dadamkovic/battery_charger_dev/hardware/production_data/v1.0/battery_charging_devboard_BOM.ods

Reference | Value | Footprint | Cost | Price | Vendor | Qty | Cost
BT1-BT3 | 18650 | User_Battery:Battery_18650 |  |  |  | 3 | 0
C1, C6, C8, C10-C15, C27-C30 | 0.1u | Capacitor_SMD:C_0805_2012Metric_Pad1.18x1.45mm_HandSolder |  |  |  | 13 | 0
C2, C3, C5, C23 | 1u | Capacitor_SMD:C_0805_2012Metric_Pad1.18x1.45mm_HandSolder |  |  |  | 4 | 0
C4 | 3.3u | Capacitor_SMD:C_0805_2012Metric_Pad1.18x1.45mm_HandSolder |  |  |  | 1 | 0
C7 | 2200p | Capacitor_SMD:C_0805_2012Metric_Pad1.18x1.45mm_HandSolder |  |  |  | 1 | 0
C9 | 2.2u | Capacitor_SMD:C_0805_2012Metric_Pad1.18x1.45mm_HandSolder |  |  |  | 1 | 0
C16 | 0.047u | Capacitor_SMD:C_0805_2012Metric_Pad1.18x1.45mm_HandSolder |  |  |  | 1 | 0
C17-C22 | 10u | Capacitor_SMD:C_1206_3216Metric_Pad1.33x1.80mm_HandSolder |  | 0.09 | https://www.mouser.com/ProductDetail/Samsung-Electro-Mechanics/CL31B106KAHNFNE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 | 6 | 0.54
C24 | 0.33u | Capacitor_SMD:C_0805_2012Metric_Pad1.18x1.45mm_HandSolder |  | 0.065 | https://www.mouser.com/ProductDetail/Samsung-Electro-Mechanics/CL21B105KOFNFNE | 1 | 0.065
C25 | 100p | Capacitor_SMD:C_0805_2012Metric_Pad1.18x1.45mm_HandSolder |  |  |  | 1 | 0
C26 | 0.01u | Capacitor_SMD:C_0805_2012Metric_Pad1.18x1.45mm_HandSolder |  |  |  | 1 | 0
C31 | 220u | Capacitor_SMD:CP_Elec_8x10 |  | 0.286 | https://www.mouser.com/ProductDetail/Nichicon/UWT1V221MNL1GS | 0 | 0
D1, D4, D12 | BAT54WS | Diode_SMD:D_SOD-323_HandSoldering |  | 0.08 | https://www.mouser.com/ProductDetail/Diodes-Incorporated/BAT54WS-7-F?qs=BJo294706GxanB6a%2FKrrdw%3D%3D | 3 | 0.24
D2 | SBR8M | Diode_SMD:D_PowerDI-5 |  | 0.48 | https://www.mouser.com/ProductDetail/Diodes-Incorporated/SBR8M100P5-13?qs=nJRy1mI8RR96yMJWqGg%252BEg%3D%3D | 1 | 0.48
D3 | BAT54C | Package_TO_SOT_SMD:SOT-23 |  | 0.113 | https://www.mouser.com/ProductDetail/onsemi/BAT54CLT3G?qs=CBDP9nzV7kkNgCKU97dzRw%3D%3D | 1 | 0.113
D5-D10 | LED | LED_SMD:LED_0805_2012Metric_Pad1.15x1.40mm_HandSolder |  |  |  | 6 | 0
D11 | MMSZ4684-TP | Diode_SMD:D_SOD-123 |  | 0.9 | https://www.mouser.com/ProductDetail/Micro-Commercial-Components-MCC/MMSZ4684-TP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 | 1 | 0.9
J1 | Conn_01x02_Male | Connector_PinHeader_2.54mm:PinHeader_1x02_P2.54mm_Vertical |  |  |  | 1 | 0
J2 | USB_C_Receptacle_USB2.0 | Connector_USB:USB_C_Receptacle_Amphenol_12401610E4-2A |  | 1.33 | https://www.mouser.com/ProductDetail/Amphenol-Commercial-Products/12401610E42A?qs=EgDjlb95zqAWvChv41w5lg%3D%3D | 1 | 1.33
J3 | DEBUG_CONN | Connector_PinHeader_2.54mm:PinHeader_1x04_P2.54mm_Horizontal |  |  | https://www.mouser.com/ProductDetail/Amphenol-FCI/78938-404HLF?qs=Owp1TJ%252B9apjkzJNnr0tajw%3D%3D | 1 | 0
J4 | UART_CONN | Connector_PinHeader_2.54mm:PinHeader_1x04_P2.54mm_Horizontal |  |  |  | 1 | 0
J5 | COMM_SELECT | Connector_PinHeader_2.54mm:PinHeader_2x06_P2.54mm_Vertical_SMD |  |  |  | 1 | 0
J6 | UART_SUPP | Connector_PinHeader_2.54mm:PinHeader_1x02_P2.54mm_Vertical_SMD_Pin1Left |  |  |  | 1 | 0
J7 | OUT_SUP | Connector_PinHeader_2.54mm:PinHeader_1x02_P2.54mm_Vertical |  |  |  | 1 | 0
L1 | 4.7u | Inductor_SMD:L_Bourns_SRN8040TA |  | 0.38 | https://www.mouser.com/ProductDetail/Bourns/SRN8040TA-4R7M?qs=Vt59ZOdFuWY5hsZr6KKjGg%3D%3D | 1 | 0.38
Q1, Q2 | DMP3036SSD | Package_SO:SO-8_3.9x4.9mm_P1.27mm |  | 0.8 | https://www.mouser.com/ProductDetail/Diodes-Incorporated/DMP3036SSD-13?qs=OVC8WVYZliQQ%252Bz8nd4Q8aA%3D%3D | 2 | 1.6
Q3 | MUN5335DW1T2G | Package_TO_SOT_SMD:SOT-363_SC-70-6_Handsoldering |  | 0.25 | https://www.mouser.com/ProductDetail/onsemi/MUN5335DW1T2G?qs=Gev%252BmEvV0ibQS1roQsXG0Q%3D%3D | 1 | 0.25
R1, R2 | 1k | Resistor_SMD:R_0805_2012Metric_Pad1.20x1.40mm_HandSolder |  |  |  | 2 | 0
R3, R4 | 49.9k | Resistor_SMD:R_0805_2012Metric_Pad1.20x1.40mm_HandSolder |  |  |  | 2 | 0
R5, R25, R35, R37, R43 | 10k | Resistor_SMD:R_0805_2012Metric_Pad1.20x1.40mm_HandSolder |  |  |  | 5 | 0
R6 | 2 | Resistor_SMD:R_0805_2012Metric_Pad1.20x1.40mm_HandSolder |  |  |  | 1 | 0
R7, R8, R33 | 4k | Resistor_SMD:R_0805_2012Metric_Pad1.20x1.40mm_HandSolder |  |  |  | 3 | 0
R9, R11, R29 | 10 | Resistor_SMD:R_0805_2012Metric_Pad1.20x1.40mm_HandSolder |  |  |  | 3 | 0
R10, R12 | 10m | Resistor_SMD:R_1206_3216Metric_Pad1.30x1.75mm_HandSolder |  | 0.15 | https://www.mouser.com/ProductDetail/Bussmann-Eaton/MFL1206R0100FS | 2 | 0.3
R13, R16, R19-R22, R27 | 5.1k | Resistor_SMD:R_0805_2012Metric_Pad1.20x1.40mm_HandSolder |  |  |  | 7 | 0
R14, R17, R42, R45, R46 | 2k | Resistor_SMD:R_0805_2012Metric_Pad1.20x1.40mm_HandSolder |  |  |  | 5 | 0
R15 | N/A | Resistor_SMD:R_0805_2012Metric_Pad1.20x1.40mm_HandSolder |  |  |  | 1 | 0
R18 | 0k | Resistor_SMD:R_0805_2012Metric_Pad1.20x1.40mm_HandSolder |  |  |  | 1 | 0
R23 | 4.7K | Resistor_SMD:R_0805_2012Metric_Pad1.20x1.40mm_HandSolder |  |  |  | 1 | 0
R24, R28 | 2.2k | Resistor_SMD:R_0805_2012Metric_Pad1.20x1.40mm_HandSolder |  |  |  | 2 | 0
R26, R34, R36 | 50k | Resistor_SMD:R_0805_2012Metric_Pad1.20x1.40mm_HandSolder |  |  |  | 3 | 0
R30 | 316k | Resistor_SMD:R_0805_2012Metric_Pad1.20x1.40mm_HandSolder |  |  |  | 1 | 0
R31 | 430k | Resistor_SMD:R_0805_2012Metric_Pad1.20x1.40mm_HandSolder |  |  |  | 1 | 0
R32 | 66.5k | Resistor_SMD:R_0805_2012Metric_Pad1.20x1.40mm_HandSolder |  |  |  | 1 | 0
R38-R41 | 660 | Resistor_SMD:R_0805_2012Metric_Pad1.20x1.40mm_HandSolder |  |  |  | 4 | 0
R44 | 58k | Resistor_SMD:R_0805_2012Metric_Pad1.20x1.40mm_HandSolder |  |  |  | 1 | 0
SW1 | BAT_IND | Button_Switch_SMD:SW_SPST_PTS810 |  | 0.3 | https://www.mouser.com/ProductDetail/CK/PTS810SJK250SMTRLFS?qs=UxeAxwACbqlfHzoZSrW3%2Fw%3D%3D | 1 | 0.3
TP1, TP3 | HPI_INT | TestPoint:TestPoint_Pad_2.5x2.5mm |  |  |  | 2 | 0
TP2 | ACOK_TP | TestPoint:TestPoint_Pad_2.5x2.5mm |  |  |  | 1 | 0
TP4 | debug_gnd | TestPoint:TestPoint_Pad_D1.0mm |  |  |  | 1 | 0
TP5 | debug_swdio | TestPoint:TestPoint_Pad_D1.0mm |  |  |  | 1 | 0
TP6 | debug_3V3 | TestPoint:TestPoint_Pad_D1.0mm |  |  |  | 1 | 0
TP7 | debug_swclk | TestPoint:TestPoint_Pad_D1.0mm |  |  |  | 1 | 0
U1, U2, U4-U6 | RQ3E100BN | User_Mosfet:HSMT8 |  | 0.3 | https://www.mouser.com/ProductDetail/ROHM-Semiconductor/RQ3E100BNTB?qs=npTsUczJOtO8HxsK5LUjOw%3D%3D | 5 | 1.5
U3 | BQ24725A | Package_DFN_QFN:Texas_S-PVQFN-N20_EP2.4x2.4mm |  | 2.9 | https://www.mouser.com/ProductDetail/Texas-Instruments/BQ24725ARGRR?qs=wqKrPCMdR%252BaY3f%2FZIDhYvQ%3D%3D | 1 | 2.9
U7 | CYPD3177 | Package_DFN_QFN:QFN-24-1EP_4x4mm_P0.5mm_EP2.65x2.65mm |  | 2.2 | https://www.mouser.com/ProductDetail/Infineon-Technologies/CYPD3177-24LQXQ?qs=PzGy0jfpSMvR3aDH5AdWfA%3D%3D | 1 | 2.2
U8 | T2N7002AK | Package_TO_SOT_SMD:SOT-23 |  | 0.14 | https://www.mouser.com/ProductDetail/Toshiba/T2N7002AKLM?qs=pzVvXTvk9PzfX4hYglwZ9Q%3D%3D | 1 | 0.14
U9 | STM32F042F6Px | Package_SO:TSSOP-20_4.4x6.5mm_P0.65mm |  | 3 |  | 1 | 3
U10 | L78L33_SO8 | Package_SO:SOIC-8_3.9x4.9mm_P1.27mm |  | 0.1 |  | 1 | 0.1
Total |  |  |  |  |  | #NAME? | 16.338
