dadamkovic/battery_charger_dev/hardware/battery_charging_devboard.kicad_pcb

## KiCad design hardware/battery_charging_devboard.kicad_pcb (2024-06-29)

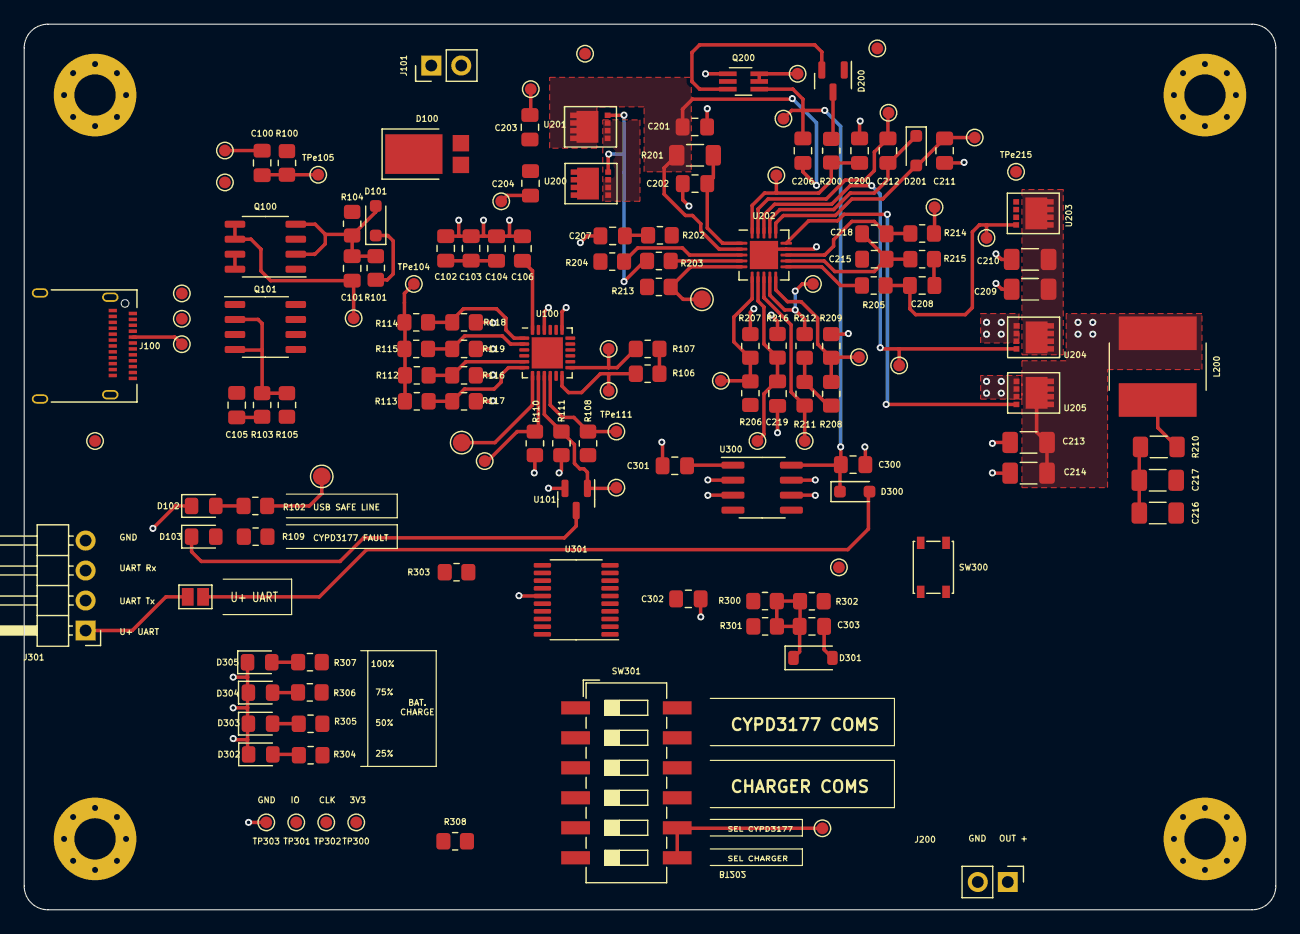
[picture p1: board battery_charging_devboard.kicad_pcb from above]

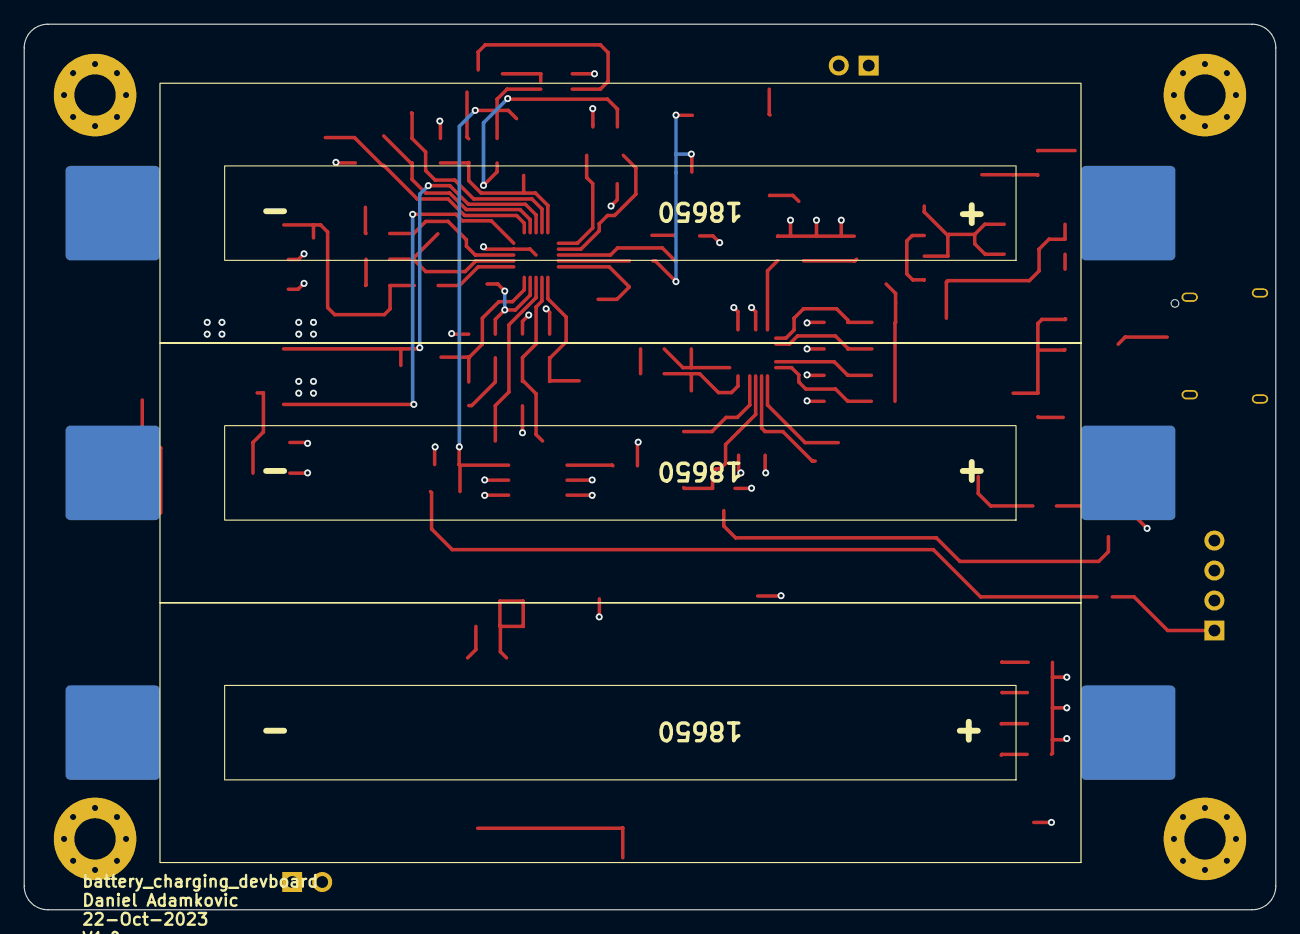
[picture p2: board battery_charging_devboard.kicad_pcb from below]

Board: 4 copper layers, 106.0 x 75.0 mm, 157 parts (3 on the bottom side), 84 nets.

Parts:
B501, B502, B503, B504: MountingHole_Pad; MountingHole_3.5mm_Pad_Via
BT200, BT201, BT202: 18650; Battery_18650
C100, C101, C102, C106: 1u; C_0805_2012Metric_Pad1.18x1.45mm_HandSolder
C103, C104, C200, C201, C202, C204, C206, C211, C215, C218, C301, C302, C303: 0.1u; C_0805_2012Metric_Pad1.18x1.45mm_HandSolder
C105: 3.3u; C_0805_2012Metric_Pad1.18x1.45mm_HandSolder
C203: 2200p; C_0805_2012Metric_Pad1.18x1.45mm_HandSolder
C207: 2.2u; C_0805_2012Metric_Pad1.18x1.45mm_HandSolder
C208: 0.01u; C_0805_2012Metric_Pad1.18x1.45mm_HandSolder
C209, C210, C213, C214, C216, C217: 10u; C_1206_3216Metric_Pad1.33x1.80mm_HandSolder
C212: 0.047u; C_0805_2012Metric_Pad1.18x1.45mm_HandSolder
C219: 100p; C_0805_2012Metric_Pad1.18x1.45mm_HandSolder
C300: 0.33u; C_0805_2012Metric_Pad1.18x1.45mm_HandSolder
D100: SBR8M; D_PowerDI-5
D101, D201, D300: BAT54WS; D_SOD-323_HandSoldering
D102, D103, D302, D303, D304, D305: LED; LED_0805_2012Metric_Pad1.15x1.40mm_HandSolder
D200: BAT54C; SOT-23
D301: MMSZ4684-TP; D_SOD-123
J100: USB_C_Receptacle_USB2.0; USB_C_Receptacle_Amphenol_12401610E4-2A
J101: Conn_01x02_Male; PinHeader_1x02_P2.54mm_Vertical
J200: OUT_SUP; PinHeader_1x02_P2.54mm_Vertical
J300: UART_SUPP; SolderJumper-2_P1.3mm_Open_Pad1.0x1.5mm
J301: UART_CONN; PinHeader_1x04_P2.54mm_Horizontal
L200: 4.7u; L_Bourns_SRN8040TA
Q100, Q101: DMP3036SSD; SO-8_3.9x4.9mm_P1.27mm
Q200: MUN5335DW1T2G; SOT-363_SC-70-6_Handsoldering
R100, R211, R212, R213, R302: 10k; R_0805_2012Metric_Pad1.20x1.40mm_HandSolder
R101, R103: 49.9k; R_0805_2012Metric_Pad1.20x1.40mm_HandSolder
R102, R109, R301, R303, R308: 2k; R_0805_2012Metric_Pad1.20x1.40mm_HandSolder
R104, R105: 1k; R_0805_2012Metric_Pad1.20x1.40mm_HandSolder
R106, R107: 2.2k; R_0805_2012Metric_Pad1.20x1.40mm_HandSolder
R108: 4.7K; R_0805_2012Metric_Pad1.20x1.40mm_HandSolder
R110, R112, R114, R116, R117, R118, R119: 5.1k; R_0805_2012Metric_Pad1.20x1.40mm_HandSolder
R111, R209, R216: 50k; R_0805_2012Metric_Pad1.20x1.40mm_HandSolder
R113: N/A; R_0805_2012Metric_Pad1.20x1.40mm_HandSolder
R115: 0k; R_0805_2012Metric_Pad1.20x1.40mm_HandSolder
R200, R214, R215: 10; R_0805_2012Metric_Pad1.20x1.40mm_HandSolder
R201, R210: 10m; R_1206_3216Metric_Pad1.30x1.75mm_HandSolder
R202: 2; R_0805_2012Metric_Pad1.20x1.40mm_HandSolder
R203, R204, R205: 4k; R_0805_2012Metric_Pad1.20x1.40mm_HandSolder
R206: 430k; R_0805_2012Metric_Pad1.20x1.40mm_HandSolder
R207: 66.5k; R_0805_2012Metric_Pad1.20x1.40mm_HandSolder
R208: 316k; R_0805_2012Metric_Pad1.20x1.40mm_HandSolder
R300: 58k; R_0805_2012Metric_Pad1.20x1.40mm_HandSolder
R304, R305, R306, R307: 660; R_0805_2012Metric_Pad1.20x1.40mm_HandSolder
SW300: BAT_IND; SW_SPST_PTS810
SW301: SW_DIP_x06; SW_DIP_SPSTx06_Slide_6.7x16.8mm_W8.61mm_P2.54mm_LowProfile
TP100, TP101: HPI_INT; TestPoint_Pad_D1.5mm
TP200: ACOK_TP; TestPoint_Pad_D1.5mm
TP300: debug_3V3; TestPoint_Pad_D1.0mm
TP301: debug_swdio; TestPoint_Pad_D1.0mm
TP302: debug_swclk; TestPoint_Pad_D1.0mm
TP303: debug_gnd; TestPoint_Pad_D1.0mm
TPe100, TPe101, TPe102, TPe103, TPe104, TPe105, TPe106, TPe107, TPe108, TPe109, TPe110, TPe111, TPe112, TPe113, TPe200, TPe201, TPe202, TPe203, TPe204, TPe206, TPe207, TPe208, TPe209, TPe210, TPe211, TPe212, TPe213, TPe214, TPe215, TPe216, TPe217, TPe218, TPe300, TPe301: TestPoint; TestPoint_Pad_D1.0mm
U100: CYPD3177; QFN-24-1EP_4x4mm_P0.5mm_EP2.65x2.65mm
U101: T2N7002AK; SOT-23
U200, U201, U203, U204, U205: RQ3E100BN; HSMT8
U202: BQ24725A; Texas_S-PVQFN-N20_EP2.4x2.4mm
U300: L78L33_SO8; SOIC-8_3.9x4.9mm_P1.27mm
U301: STM32F042F6Px; TSSOP-20_4.4x6.5mm_P0.65mm

Connections:
/microcontroller/uC_clk: SW301.10, SW301.12, U301.1 (PB8)
/microcontroller/uC_sda: SW301.9, SW301.11, U301.2 (PF0)
/microcontroller/uC_sel_comms: SW301.7, SW301.8, TPe301.1, U301.3 (PF1)
/microcontroller/uC_swdio: TP301.1, U301.19 (PA13)
/microcontroller/uC_uart_rx: J301.3, U301.9 (PA3)
/microcontroller/uC_uart_tx: J301.2, U301.8 (PA2)
/microcontroller/uc_swclk: TP302.1, U301.20 (PA14)
/usb_input/BACKUP_POWER: D100.2 (A), J101.2
/usb_input/CC1: J100.A5 (CC1), TPe108.1, U100.15 (CC1)
/usb_input/CC2: J100.B5 (CC2), TPe109.1, U100.14 (CC2)
/usb_input/VDDD_3V3: C102.1, C103.1, C104.1, R112.1, R113.1, R114.1, R115.1, TPe104.1, U100.23 (VDDD)
GND: B501.1, B502.1, B503.1, B504.1, BT202.2 (-), C102.2, C103.2, C104.2, C105.2, C106.2, C200.1, C201.2, C202.2, C207.1, C209.1, C210.1, C211.2, C213.1, C214.1, C215.2, C216.1, C217.1, C219.1, C300.2, C301.2, C302.2, C303.2, D102.1 (K), D301.2 (A), D302.1 (K), D303.1 (K), D304.1 (K), D305.1 (K), J100.A1 (GND), J100.A12 (GND), J100.B1 (GND), J100.B12 (GND), J100.S1 (SHIELD), J101.1, J200.2, J301.4, Q200.1 (E1), R110.2, R111.1, R116.2, R117.2, R118.2, R119.2, R207.2, R209.2, R216.1, R302.1, R308.1, SW300.1, TP303.1, U100.19 (GND), U100.22 (VSS), U101.2 (S), U202.14 (GND), U202.21 (GND-PAD), U205.1, U205.2, U205.3, U300.2 (GND), U300.3 (GND), U300.6 (GND), U300.7 (GND), U301.15 (VSSA)
HPI_CLK: R107.2, SW301.1, TPe107.1, U100.13 (HPI_SCL)
HPI_SDA: R106.2, SW301.2, TPe110.1, U100.12 (HPI_SDA)
I2C_CLK_CHRG: R212.2, SW301.3, TPe217.1, U202.9 (SCL)
I2C_SDA_CHRG: R211.2, SW301.4, TPe216.1, U202.8 (SDA)
unnamed: BT200.2 (-), BT201.1 (+)
unnamed: BT201.2 (-), BT202.1 (+)
unnamed: C203.2, C204.2, R203.1, TPe206.1, U200.4, U201.4
unnamed: C204.1, R204.1, TPe203.1, U200.1, U200.2, U200.3, U201.1, U201.2, U201.3
unnamed: C207.2, R202.2
unnamed: C208.2, R205.1, TPe207.1, U203.4
unnamed: C100.2, C101.2, D101.2 (A), Q100.2 (G), Q100.4 (G), R100.2, R101.2, R104.1, TPe101.1
unnamed: D101.1 (K), Q100.1 (S), Q100.3 (S), R101.1, TPe100.1
unnamed: D102.2 (A), R102.1
unnamed: D103.2 (A), R109.1
unnamed: D103.1 (K), U101.3 (D)
unnamed: D200.3, R200.1
unnamed: C211.1, D201.2 (A), TPe209.1, U202.16 (REGN)
unnamed: C212.2, D201.1 (K), U202.17 (BTST)
unnamed: C303.1, D301.1 (K), R300.1, R301.2, R302.2, TPe300.1
unnamed: D302.2 (A), R304.2
unnamed: D303.2 (A), R305.2
unnamed: D304.2 (A), R306.2
unnamed: D305.2 (A), R307.2
unnamed: J300.2, J301.1
unnamed: L200.2, R210.2, R214.1, TPe213.1
unnamed: Q101.2 (G), Q101.4 (G), R103.2, R105.1, TPe103.1
unnamed: Q101.1 (S), Q101.3 (S), TPe102.1
unnamed: Q200.5 (B2), Q200.6 (C1), TPe201.1
unnamed: D200.2, Q200.3 (C2), TPe200.1
unnamed: R303.1, SW300.2
unnamed: R308.2, SW301.5
unnamed: R111.2, TPe113.1, U100.9 (FAULT), U101.1 (G)
unnamed: R108.2, TPe111.1, U100.10 (FLIP)
unnamed: TP101.1, U100.7 (HPI_INT)
unnamed: R112.2, R116.1, U100.5 (ISNK_COARSE)
unnamed: R113.2, R117.1, U100.6 (ISNK_FINE)
unnamed: R105.2, U100.4 (SAFE_PWR_EN)
unnamed: R104.2, U100.3 (VBUS_FET_EN)
unnamed: R115.2, R119.1, U100.2 (VBUS_MAX)
unnamed: R114.2, R118.1, U100.1 (VBUS_MIN)
unnamed: C106.1, U100.24 (VCCD)
unnamed: R206.2, R207.1, TPe210.1, U202.6 (ACDET)
unnamed: R203.2, U202.4 (ACDRV)
unnamed: R213.2, TP200.1, U202.5 (ACOK)
unnamed: C201.1, C206.1, R201.2, TPe208.1, U201.5, U202.2 (ACP)
unnamed: R205.2, U202.11 (BATDR)
unnamed: R204.2, U202.3 (CMSRC)
unnamed: TPe212.1, U202.18 (HIDRV), U204.4
unnamed: R208.1, R209.1, TPe211.1, U202.10 (ILIM)
unnamed: U202.15 (LODRV), U205.4
unnamed: C212.1, C213.2, C214.2, L200.1, TPe214.1, U202.19 (PHASE), U204.1, U204.2, U204.3, U205.5
unnamed: C215.1, C218.2, R215.2, U202.12 (SRN)
unnamed: C218.1, R214.2, U202.13 (SRP)
unnamed: C200.2, R200.2, TPe202.1, U202.20 (VCC)
unnamed: R301.1, U301.6 (PA0)
unnamed: R307.1, U301.7 (PA1)
unnamed: R306.1, U301.10 (PA4)
unnamed: R305.1, U301.12 (PA6)
unnamed: R304.1, U301.13 (PA7)
unnamed: R303.2, U301.14 (PB1)
POWER_SYSTEM: C202.1, C206.2, C209.2, C210.2, C300.1, D300.1 (K), J200.1, Q200.4 (E2), R201.1, TPe204.1, U202.1 (ACN), U203.5, U204.5, U300.8 (IN)
UART_SUPP_5V: D300.2 (A), J300.1
USB_C_BUS: C100.1, C105.1, J100.A4 (VBUS), J100.A9 (VBUS), J100.B4 (VBUS), J100.B9 (VBUS), Q100.7 (D), Q100.8 (G), Q101.7 (D), Q101.8 (G), R100.1, R103.1, R109.2, TPe105.1, U100.18 (VBUS_IN)
USB_C_D+: J100.A6 (D+), J100.B6 (D+), U301.18 (PA10/PA12)
USB_C_D-: J100.A7 (D-), J100.B7 (D-), U301.17 (PA9/PA11)
USB_C_GPIO: R110.1, TPe112.1, U100.8 (GPIO_1)
VREG_3V3: C301.1, C302.1, R106.1, R107.1, R108.1, R208.2, R211.1, R212.1, R213.1, TP300.1, U300.1 (OUT), U301.5 (VDDA), U301.16 (VDD)
V_USB_OUT: C101.1, C203.1, D100.1 (K), D200.1, Q100.5 (D), Q100.6 (G), R202.1, R206.1, TPe106.1, U100.11 (VDC_OUT), U200.5
V_USB_SAFE: Q101.5 (D), Q101.6 (G), R102.2, TP100.1
uC_adc_Icharge: C219.2, R216.2, TPe218.1, U202.7 (IOUT)
uC_adc_battery: BT200.1 (+), C208.1, C216.2, C217.2, R210.1, R215.1, R300.2, TPe215.1, U203.1, U203.2, U203.3
uC_bat_out_en: Q200.2 (B1), U301.11 (PA5)
