dadamkovic/battery_charger_dev/software/Core/Src/main.c

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
/* Includes ------------------------------------------------------------------*/
#include "main.h"
#include "adc.h"
#include "i2c.h"
#include "gpio.h"


void SystemClock_Config(void);
/**
  * @brief  The application entry point.
  * @retval int
  */
int main(void)
{
  /* MCU Configuration--------------------------------------------------------*/

  /* Reset of all peripherals, Initializes the Flash interface and the Systick. */
  HAL_Init();

  /* Configure the system clock */
  SystemClock_Config();

  /* Initialize all configured peripherals */
  MX_GPIO_Init();
  MX_ADC_Init();
  MX_I2C1_Init();
  /* USER CODE BEGIN 2 */
  HAL_GPIO_WritePin(LED1_OUT_GPIO_Port,LED1_OUT_Pin,GPIO_PIN_SET);
  HAL_GPIO_WritePin(BAT_EN_OUT_GPIO_Port,BAT_EN_OUT_Pin,GPIO_PIN_SET);
  uint16_t address = 0b0001001<<1;
  uint8_t bufferCurrent[16];
  bufferCurrent[0] = 0x14;
  bufferCurrent[1] = 0x00;
  bufferCurrent[2] = 0b00001100;
  uint8_t bufferVoltage[16];
  bufferVoltage[0] = 0x15;
  bufferVoltage[1] = 0x00;
  bufferVoltage[2] = 0b00110000;
  uint8_t maxCurr[16];
  maxCurr[0] = 0x3F;
  maxCurr[1] = 0x00;
  maxCurr[2] = 0b00011000;
  HAL_StatusTypeDef status;
  /* USER CODE END 2 */

  /* Infinite loop */
  /* USER CODE BEGIN WHILE */
  while (1)
  {
    /* USER CODE END WHILE */
    if(HAL_GPIO_ReadPin(BUT1_INP_GPIO_Port,BUT1_INP_Pin) == GPIO_PIN_RESET)
    {      
      status = HAL_I2C_Master_Transmit(&hi2c1,address,bufferCurrent,3,5);
      status |= HAL_I2C_Master_Transmit(&hi2c1,address,bufferVoltage,3,5);
      status |= HAL_I2C_Master_Transmit(&hi2c1,address,maxCurr,3,5);
      if(status == HAL_OK)
      {
        HAL_GPIO_WritePin(LED2_OUT_GPIO_Port,LED2_OUT_Pin,GPIO_PIN_SET);
        HAL_Delay(500);
        HAL_GPIO_WritePin(LED2_OUT_GPIO_Port,LED2_OUT_Pin,GPIO_PIN_RESET);
      }
      
    }
    /* USER CODE BEGIN 3 */
  }
  /* USER CODE END 3 */
}

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
