dadamkovic/battery_charger_dev/software/Core/Inc/main.h

#define SEL_COMS_INP_Pin GPIO_PIN_1
#define SEL_COMS_INP_GPIO_Port GPIOF
#define BAT_INP_ADC_Pin GPIO_PIN_0
#define BAT_INP_ADC_GPIO_Port GPIOA
#define LED4_OUT_Pin GPIO_PIN_1
#define LED4_OUT_GPIO_Port GPIOA
#define LED3_OUT_Pin GPIO_PIN_4
#define LED3_OUT_GPIO_Port GPIOA
#define BAT_EN_OUT_Pin GPIO_PIN_5
#define BAT_EN_OUT_GPIO_Port GPIOA
#define LED2_OUT_Pin GPIO_PIN_6
#define LED2_OUT_GPIO_Port GPIOA
#define LED1_OUT_Pin GPIO_PIN_7
#define LED1_OUT_GPIO_Port GPIOA
#define BUT1_INP_Pin GPIO_PIN_1
#define BUT1_INP_GPIO_Port GPIOB
