dadamkovic/battery_charger_dev/(commit log)

2023-10-03 Incomplete schematic, added bat charging and PD negotiation.
    [battery_charger.kicad_sch, battery_charging_devboard.kicad_pcb, battery_charging_devboard.kicad_sch, usb_input.kicad_sch]
2023-10-04 Added microcontroller stage. Need to fix the supply routing to power from battery.
    [battery_charger.kicad_sch, battery_charging_devboard.kicad_sch, microcontroller.kicad_sch, usb_input.kicad_sch]
2023-10-15 Schematic completed. Started routing.
    [battery_charger.kicad_sch, battery_charging_devboard.kicad_pcb, microcontroller.kicad_sch, usb_input.kicad_sch]
2023-10-22 Re-reouting the USB C CCX lines
    [battery_charger.kicad_sch, battery_charging_devboard.kicad_pcb, microcontroller.kicad_sch, usb_input.kicad_sch]
2024-02-18 Restructured repo
    [battery_charger.kicad_sch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]
2024-06-29 Continuing routing
    [battery_charger.kicad_sch, battery_charging_devboard.kicad_pcb, battery_charging_devboard.kicad_sch, microcontroller.kicad_sch, mounting_holes.kicad_sch, usb_input.kicad_sch]
